leo09p/Impedance-measurement-system/Media/Readme

Esta carpeta contiene material visual relacionado con el proyecto, incluyendo imágenes y videos de demostración del funcionamiento de la app como de la simulación

Entre estos archivos se incluye un video donde se muestra la visualización en tiempo real de los datos en la aplicación móvil durante las pruebas experimentales del sistema.
