leo09p/Impedance-measurement-system/Hardware/EasyEDA/Readme

Esta carpeta contiene los archivos del diseño electrónico desarrollados en EasyEDA.

Aquí se encuentran el esquemático del circuito, el diseño del layout de la PCB y los archivos necesarios para la fabricación de la placa
