leo09p/Impedance-measurement-system/Hardware/Proteus/simu2.png

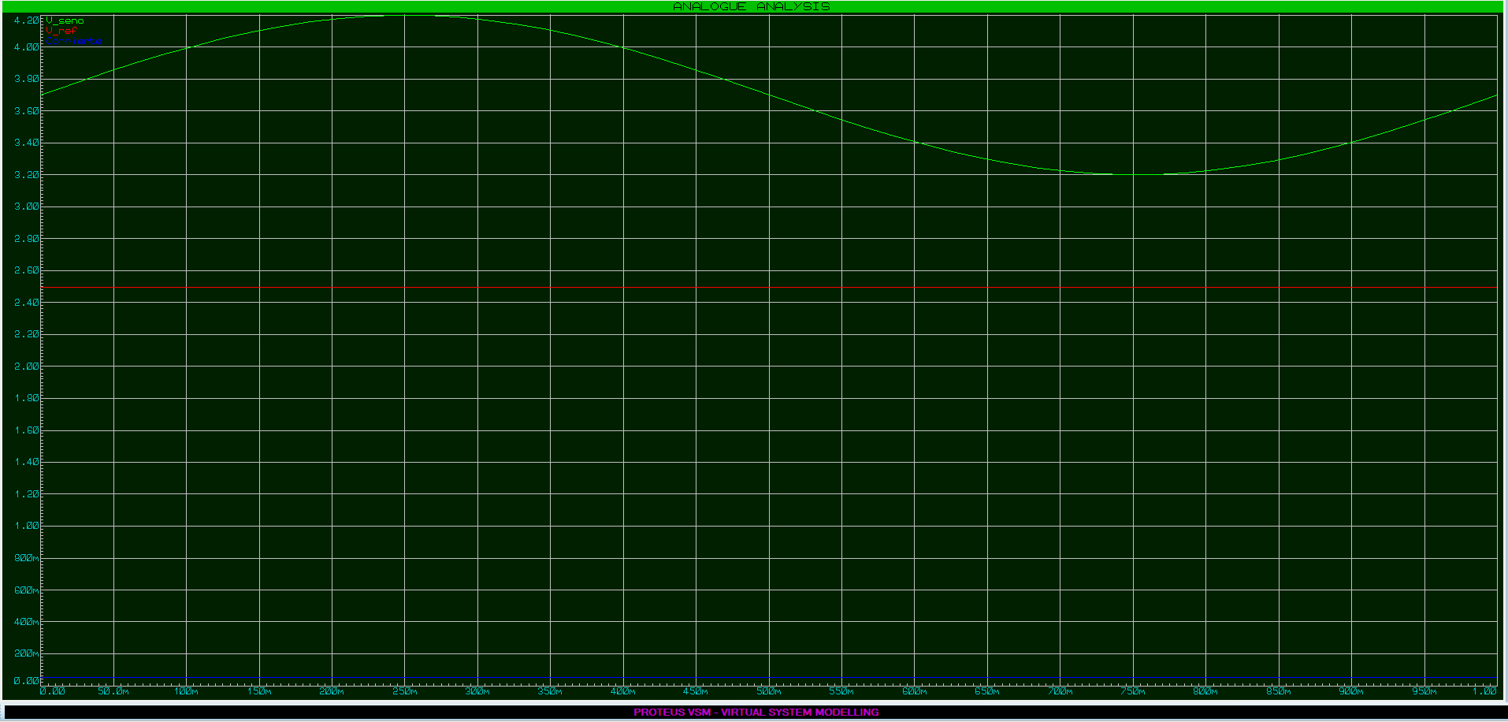
Hardware/Proteus/simu2.png
