leo09p/Impedance-measurement-system/Media/Images/Proteus.png

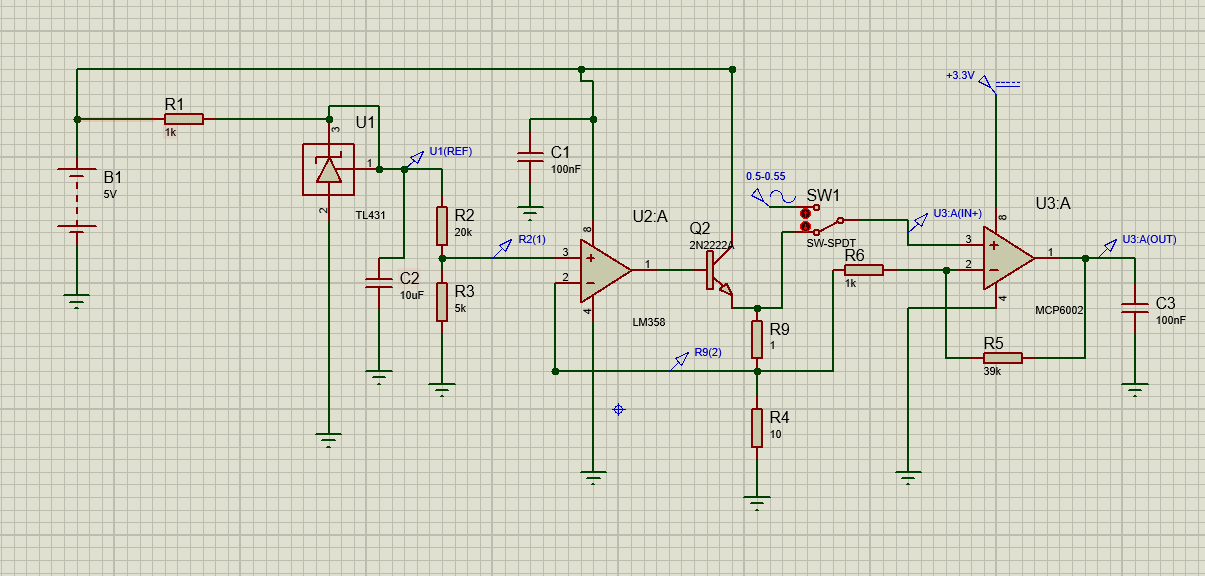
Media/Images/Proteus.png
