leo09p/Impedance-measurement-system/Media/Images/Proteus_grafica.png

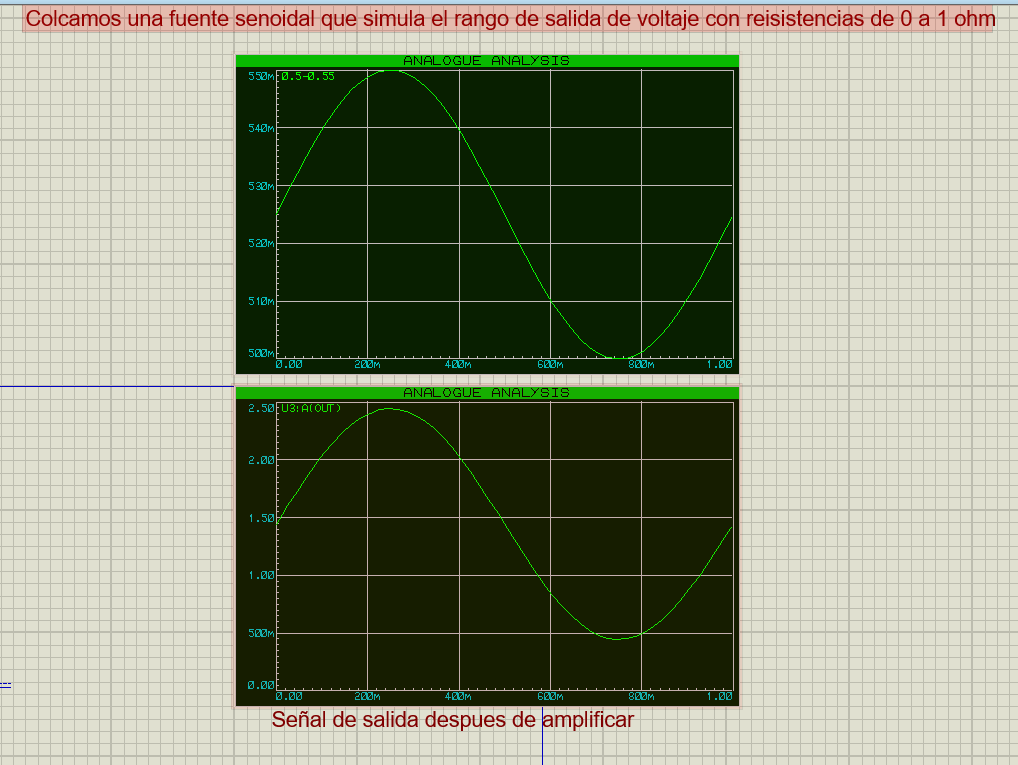
Media/Images/Proteus_grafica.png
