leo09p/Impedance-measurement-system/Docs/Tabla de componentes.png

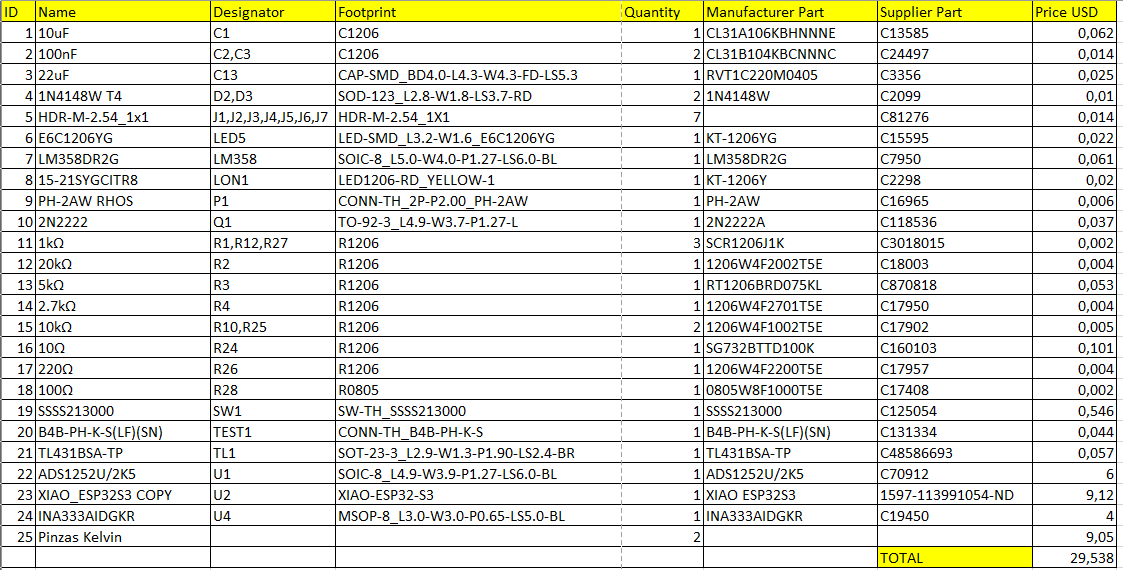
Docs/Tabla de componentes.png
