leo09p/Impedance-measurement-system/Hardware/EasyEDA/Schematic_miliohn_.pdf

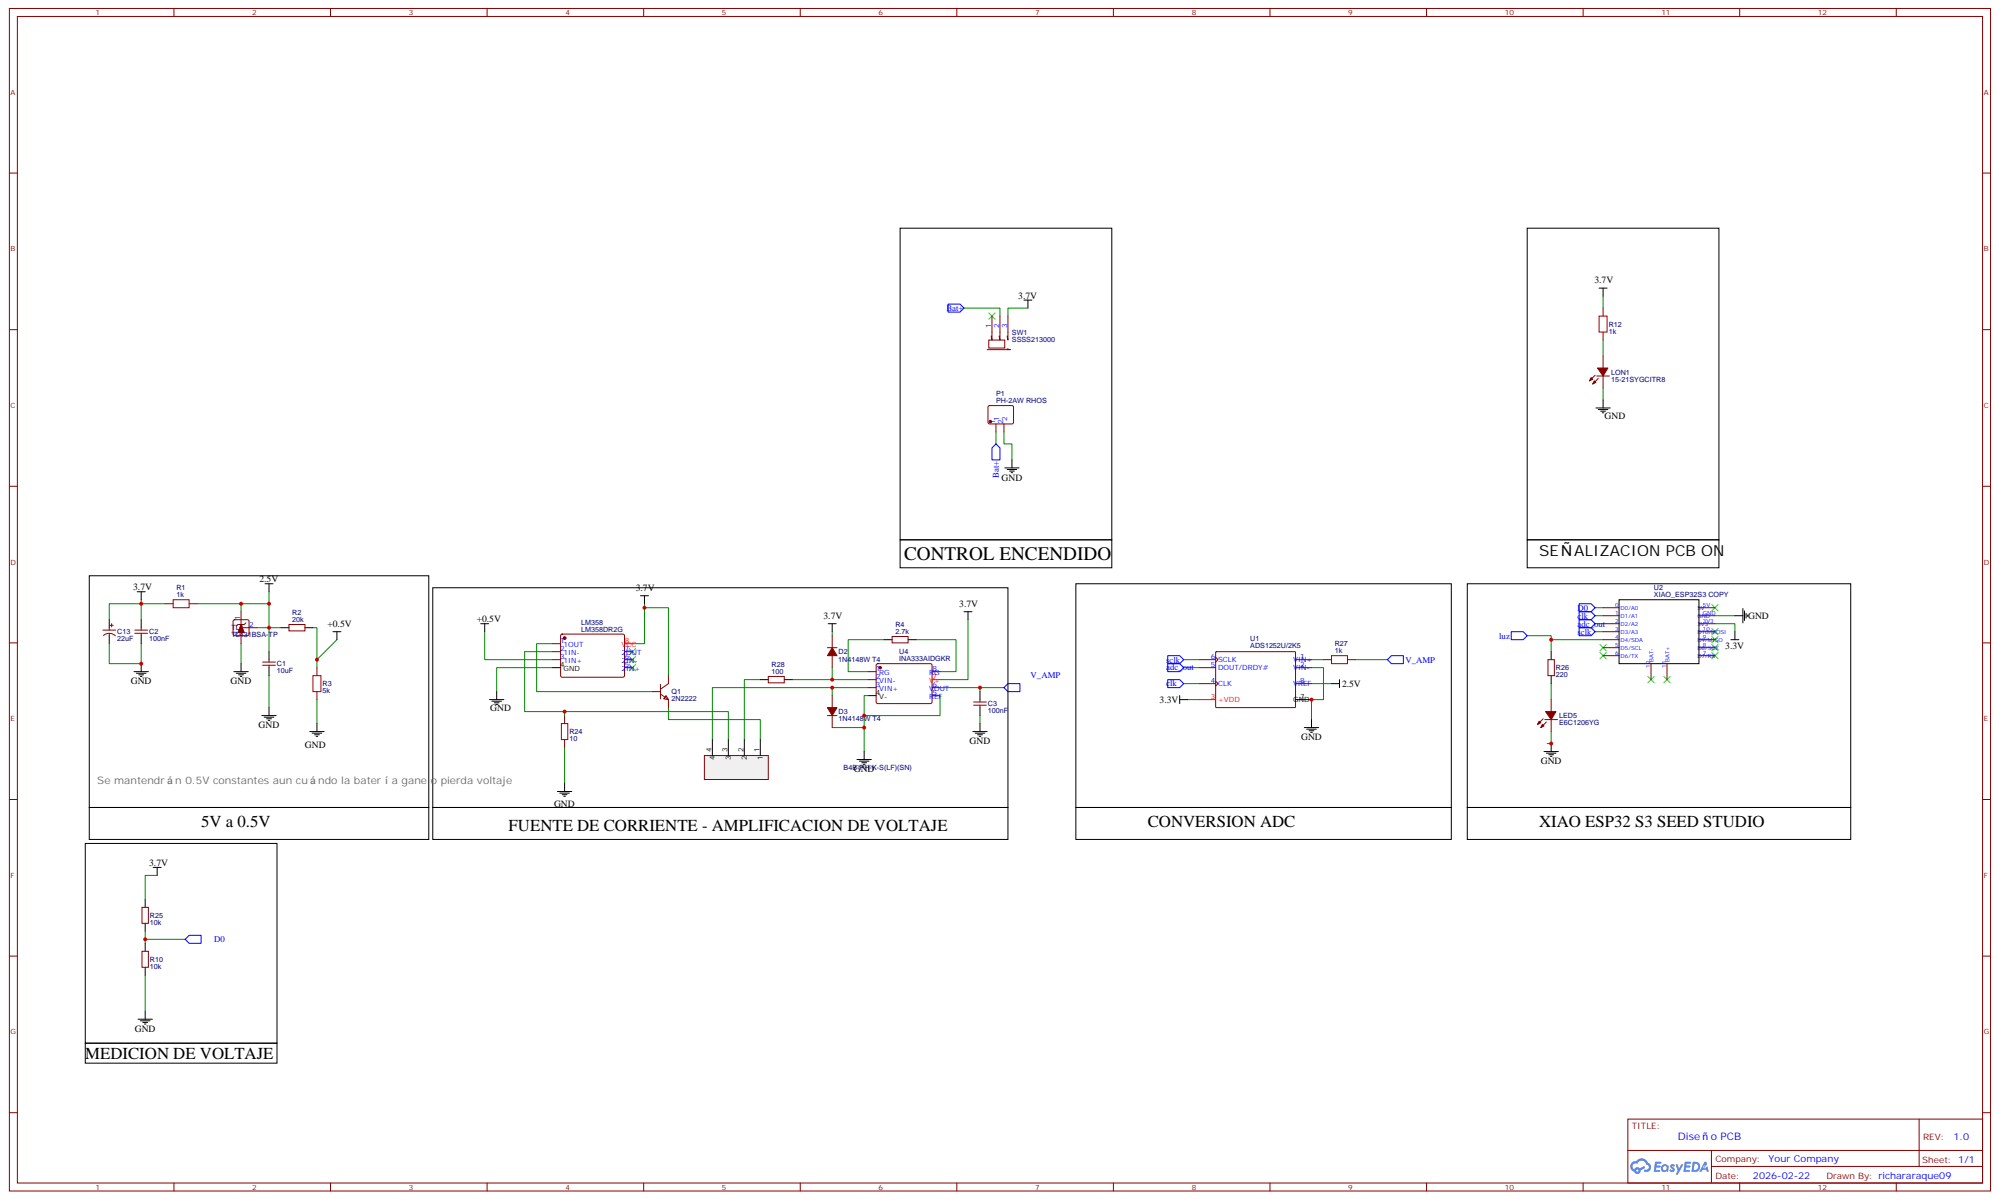
[picture p19: page 1]

SE ALIZACION PCB ON

B4B-PH-K-S(LF)(SN) GND

Se mantendr n 0.5V constantes aun cu ndo la bater a gane o pierda voltaje

GND
FUENTE DE CORRIENTE - AMPLIFICACION DE VOLTAJE
