leo09p/Impedance-measurement-system/Hardware/EasyEDA/PCB_PCB_miliohn.pdf

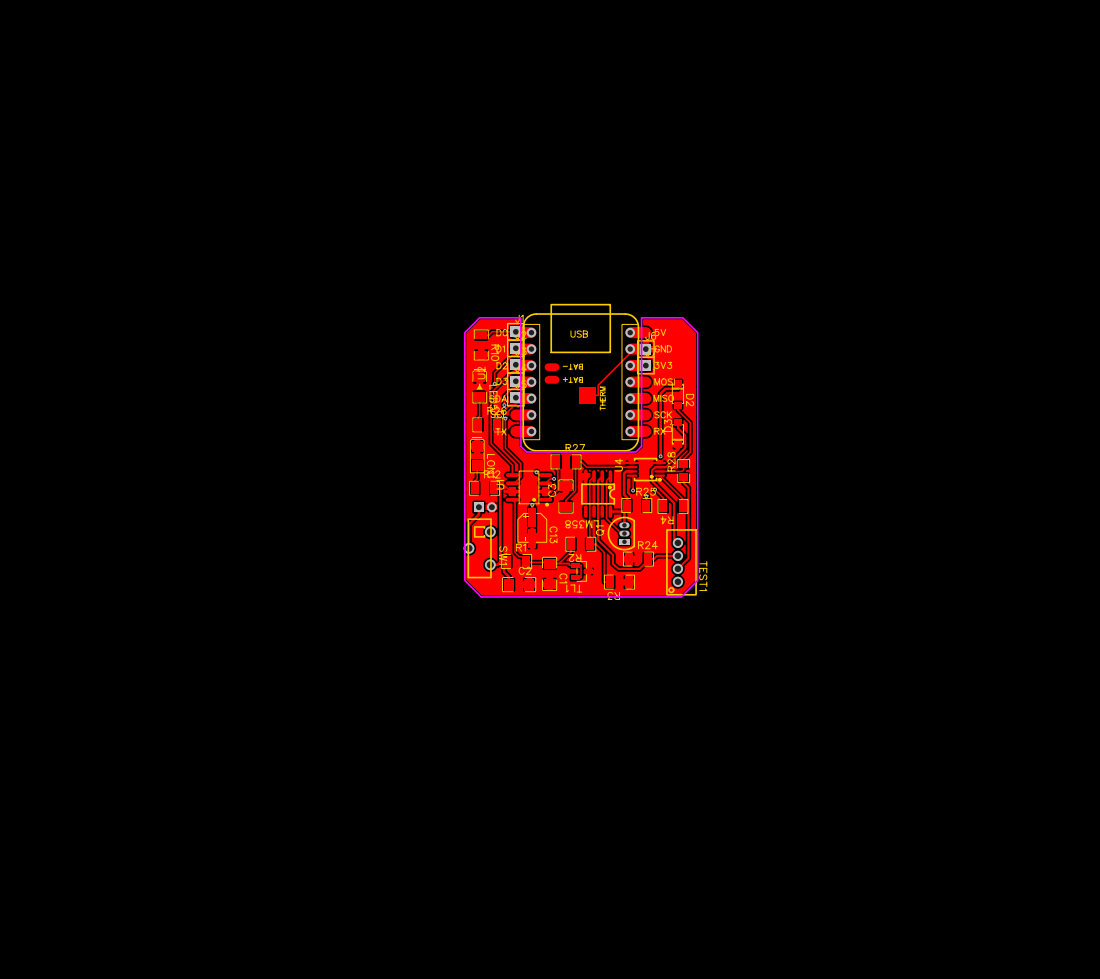
[picture p20: page 1]
