leo09p/Impedance-measurement-system/(list of files, drawings)

Other design files:
Hardware/EasyEDA/SCH_miliohn_2026-04-19.json
Hardware/Proteus/simulacion_proteus_medidor.pdsprj
