leo09p/Impedance-measurement-system/(commit log)

2026-03-08 Update Readme with app and simulation details
    Clarified description of visual materials related to the project.
2026-04-27 Update microcontroller reference to Xiao ESP32
